keynesproject/FbLike/Circuit/FbLike_EP2/FbLike_EP2.brd

## EAGLE design Circuit/FbLike_EP2/FbLike_EP2.brd (2016-09-17)

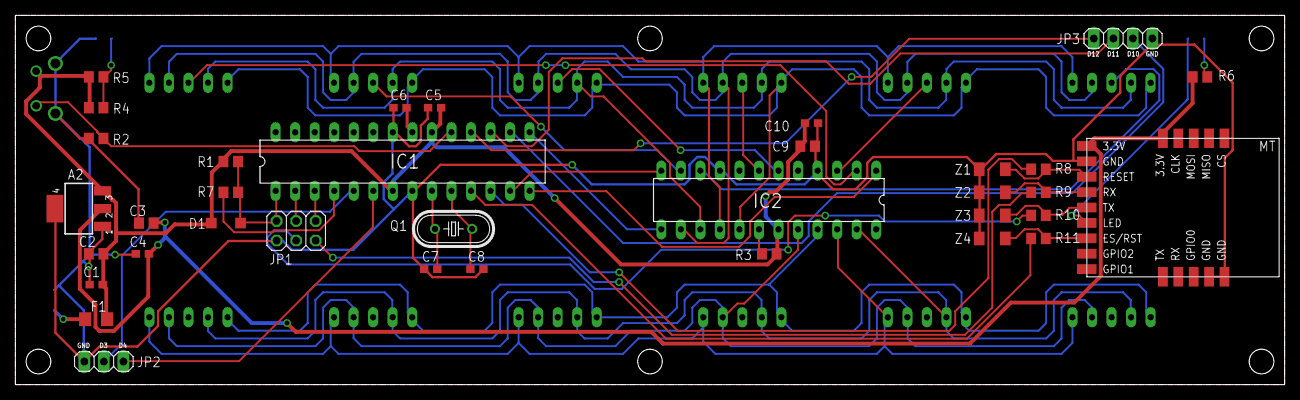
[picture p1: board FbLike_EP2.brd from above]

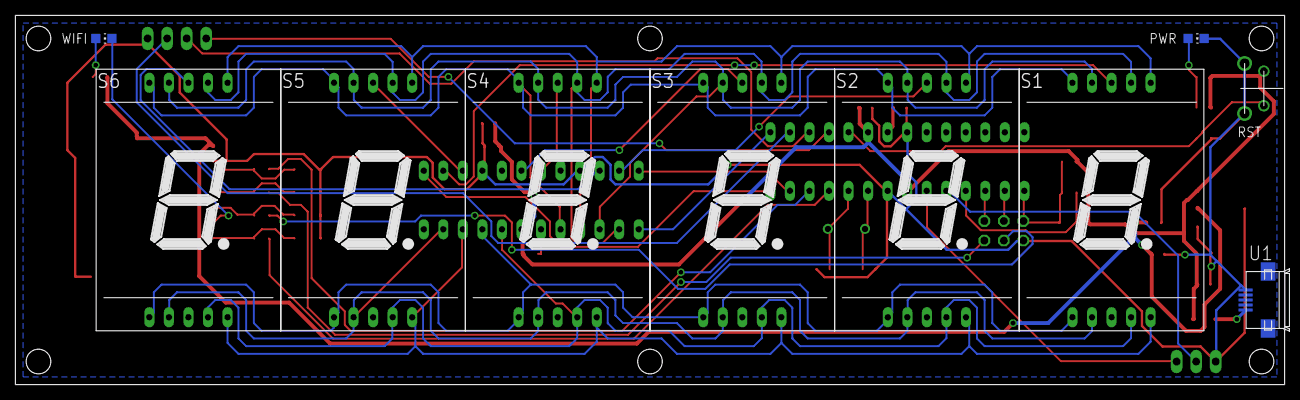
[picture p2: board FbLike_EP2.brd from below]

Board: 2 copper layers, 165.0 x 48.0 mm, 45 parts (10 on the bottom side), 46 nets.

Parts:
A2: 3.3V; SOT223
C1, C4, C5, C6, C10: 0.1uf; C0603
C2, C3, C9: 10uf; C0805
C7, C8: 22pf; C0603
D1: 1N4148; SOD123
F1: 0.5A; R1206
IC1: DIL28-3
IC2: DIL24-3
JP1: 2X03
JP2: 1X03
JP3: 1X04
MT: HLK-M35-PAD
PWR: RED; CHIP-LED0805
Q1: 16Mhz; HC49U-V
R1, R2: 10K; R0805
R3: 22.6K; R0805
R4, R5, R6, R7: 1K; R0805
R8, R9, R10, R11: 200; R0805
RST: BUTTON-66-90DEG; BUTTON-6*6-90DEG
S1, S2, S3, S4, S5, S6: 7SEG-1INCH
U1: MICRO-USB-B
WIFI: BLUE; CHIP-LED0805
Z1, Z2, Z3, Z4: 3.3V; LL-34

Connections:
+3V3: A2.2, C3.1, C4.1, MT.P$1, MT.P$19, R6.1
+5V: A2.3, C1.1, C2.1, C5.1, C9.1, C10.1, D1.C, F1.2, IC1.7, IC1.20, IC2.19, R1.1, R3.2, R4.2, R5.1, RST.P$3
BTN_RST: IC1.19, R2.2, RST.P$2
GND: A2.1, A2.4, C1.2, C2.2, C3.2, C4.2, C5.2, C6.1, C7.1, C8.1, C9.2, C10.2, IC1.8, IC1.22, IC2.4, IC2.9, JP1.1, JP2.1, JP3.4, MT.P$2, MT.P$13, MT.P$14, PWR.C, R2.1, RST.P$1, RST.P$4, U1.P5, Z1.2, Z2.2, Z3.2, Z4.2
IC1_RESET: IC1.4, R7.2
IC2_CLK: IC1.15, IC2.13
IC2_DIN: IC1.14, IC2.1
IC2_LOAD: IC1.13, IC2.12
JP1_P2: D1.A, IC1.1, JP1.2, R1.2, R7.1
JP1_P4: IC1.2, JP1.4
JP1_P6: IC1.3, JP1.6
JP2_P2: IC1.5, JP2.2
JP2_P3: IC1.6, JP2.3
JP3_P1: IC1.18, JP3.1
JP3_P2: IC1.17, JP3.2
JP3_P3: IC1.16, JP3.3
M35_ES: IC1.11, R11.1
M35_RESET: IC1.12, R8.1
unnamed: R6.2, WIFI.A
unnamed: C6.2, IC1.21
unnamed: C7.2, IC1.9, Q1.2
unnamed: C8.2, IC1.10, Q1.1
unnamed: IC2.14, S1.7, S2.7, S3.7, S4.7, S5.7, S6.7
unnamed: IC2.16, S1.6, S2.6, S3.6, S4.6, S5.6, S6.6
unnamed: IC2.20, S1.4, S2.4, S3.4, S4.4, S5.4, S6.4
unnamed: IC2.23, S1.2, S2.2, S3.2, S4.2, S5.2, S6.2
unnamed: IC2.21, S1.1, S2.1, S3.1, S4.1, S5.1, S6.1
unnamed: IC2.10, S6.8
unnamed: IC2.15, S1.9, S2.9, S3.9, S4.9, S5.9, S6.9
unnamed: IC2.17, S1.10, S2.10, S3.10, S4.10, S5.10, S6.10
unnamed: IC2.22, S1.5, S2.5, S3.5, S4.5, S5.5, S6.5
unnamed: IC2.3, S5.8
unnamed: IC2.7, S4.8
unnamed: IC2.6, S3.8
unnamed: IC2.11, S2.8
unnamed: IC2.2, S1.8
unnamed: JP1.5, R9.1
unnamed: JP1.3, R10.1
unnamed: MT.P$3, R8.2, Z1.1
unnamed: IC2.18, R3.1
unnamed: MT.P$4, R9.2, Z2.1
unnamed: MT.P$5, R10.2, Z3.1
unnamed: MT.P$7, R11.2, Z4.1
unnamed: PWR.A, R4.1, R5.2
WIFI_LED: MT.P$6, WIFI.C
XUSB: F1.1, U1.P1
