keynesproject/FbLike/(commit log)

2015-06-29 New Project
    [FbLike.sch]
2015-10-17 Add New Project Use new wifi modular MT7681
    [FbLike.sch]
2015-10-19 bug fix : The data from Facebook api request analyze function.
    [FbLike_EP2.ino, WifiProcess.cpp, WifiProcess.h]
2015-12-06 Modify Pin Table
2015-12-06 Add Fblike Ep2 circuit
    [FbLike_EP2.brd]
2015-12-07 增加錯誤顯示 WIFI沒連線到AP -> IF E03 FB請求的ID錯誤 -> Fb EId
2015-12-07 數值微調
2015-12-15 新增 數字遞增滾動特效
2015-12-19 增加 數字特效
2015-12-19 加入 Watchdog 功能
2016-01-22 修正顯示動畫
